synrais/ArduinoOBI-Auto-RP2040/(commit log)

2026-04-24 Update optional load resistor information in README
    Clarified the optional load resistor requirement for waking batteries from deep sleep state.
2026-04-24 Add note on using 1 kΩ resistor for battery wake-up
    Added note about grounding the enable pin for battery wake-up.
2026-04-24 Add supported battery types section to README
    Added a section detailing supported battery types, including their characteristics and limitations.
2026-04-24 Restore frame data printing in Serial output
    Reintroduced printing of the frame data in the output.
2026-04-25 Fix wording in README for battery insertion instructions
2026-04-26 Refactor lock_pin_read and update LED handling
2026-04-26 Change LED indication from orange to purple
2026-04-26 Fix formatting in README.md for battery status
2026-04-29 Update ESP32-C3/RP2040 Zero pull-up instructions
    Clarify connection instructions for ESP32-C3 and RP2040 Zero regarding pull-up resistors and battery connections.
2026-05-02 Revise lock mode details and GPIO pin usage
    Updated lock mode instructions and GPIO pin references in the README.
2026-05-04 Revise pull-up voltage and battery wake-up instructions
    Updated pull-up resistor values and connection precautions for ESP32-C3 and RP2040 Zero. Clarified instructions for waking up batteries from deep sleep state.
2026-05-06 Fix comments to use 'nybble' instead of 'nibble'
    [main.cpp]
2026-05-06 Fix typos in FRAME_REFERENCE.md regarding 'nybble'
2026-05-06 Refactor lock cause checks and update print statements
2026-05-06 Revise FRAME_REFERENCE.md for clarity and updates
    Updated FRAME_REFERENCE.md to clarify repair notes, frame write safety, and battery behavior. Revised sections and added details on byte modifications and their implications.
2026-05-08 Refine README sections on frame repair and lock mode
    Updated the README to clarify the frame repair process and omega lock mode details.
2026-05-08 Revise FRAME_REFERENCE.md for clarity and updates
    Updated frame reference documentation with clarifications on charger validation, frame repair procedures, and confirmed behaviors from systematic testing.
2026-05-08 Revise BYTE_REFERENCE.md for charger validation details
    Updated charger validation notes and clarified byte preservation requirements.
2026-05-08 Update entry 31 in Charger validation results
    Removed the note about AUX checksums for entry 31.
2026-05-08 Update validation results for charger test cases
2026-05-08 Correct typo in charger validation results
2026-05-08 Clarify charging behavior for specific nybbles
    Updated the wording for clarity on charging behavior related to Nybbles 34, 41, and 43.
2026-05-08 Update FRAME_REFERENCE.md with variant details
2026-05-08 Fix typo in Charger validation results documentation
2026-05-09 Clarify optional load resistor note in README
    Removed redundant explanation about the optional load resistor for battery wake-up.
2026-05-15 Change 'Best capacity' to 'Target capacity' in output
